zephyr5028/pese-ruche-lora-esp32/schemas/systeme pesee ruche 3.pdf

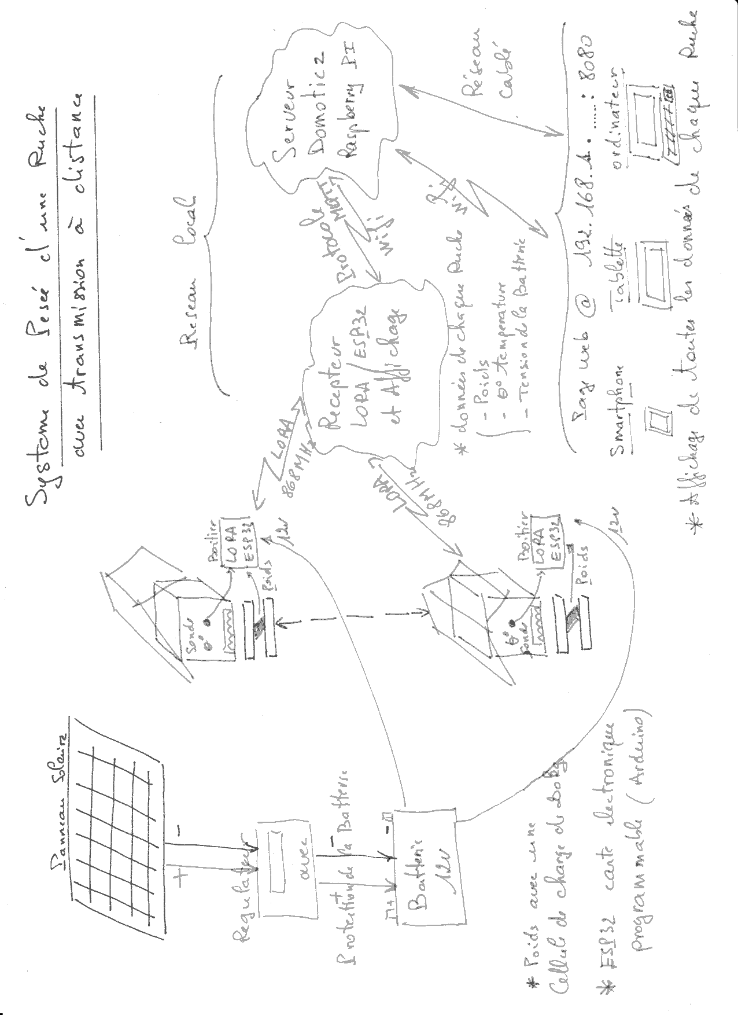
[picture p2: page 1]
