zephyr5028/pese-ruche-lora-esp32/documentation/pese ruche support.pdf

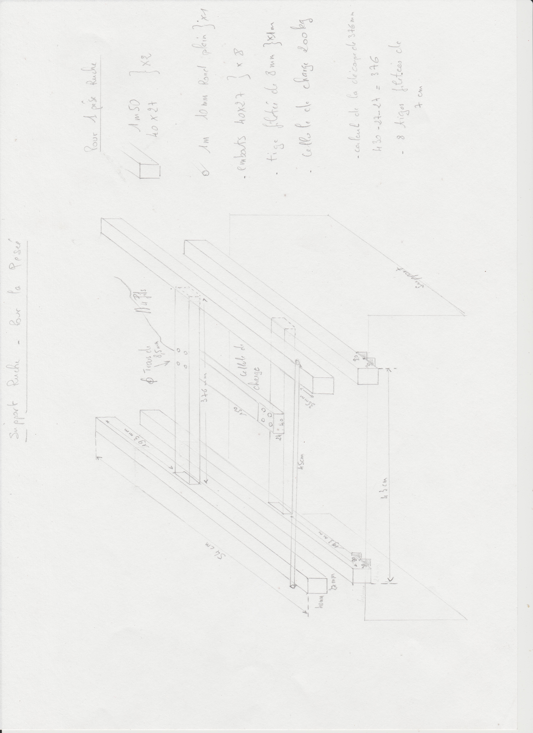
[picture p3: page 1]
