zephyr5028/pese-ruche-lora-esp32/schemas/schema pese ruche rfm95 esp32.pdf

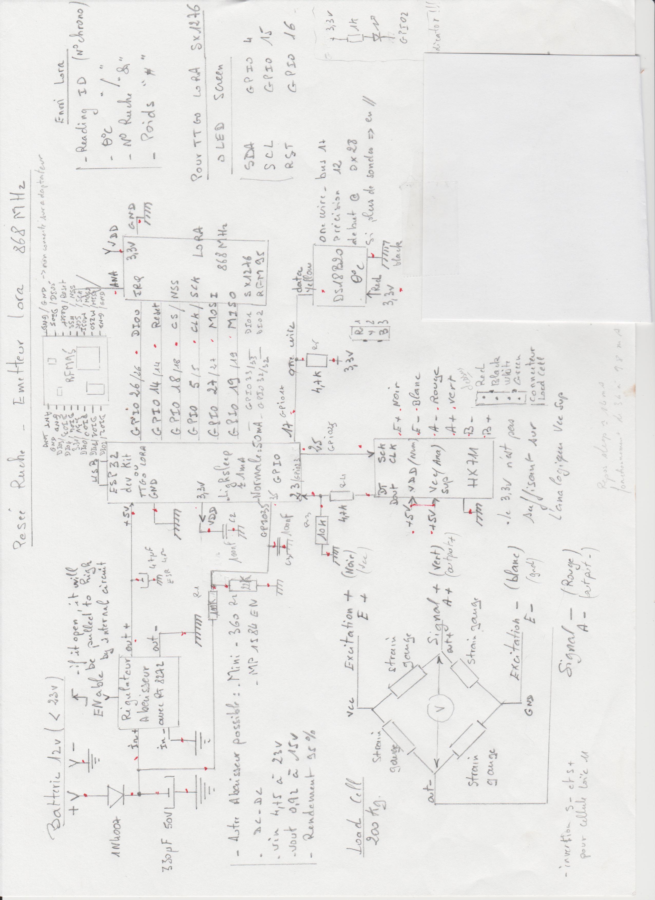
[picture p4: page 1]
