zephyr5028/pese-ruche-lora-esp32/schemas/plan pese ruche acier 200kg.pdf

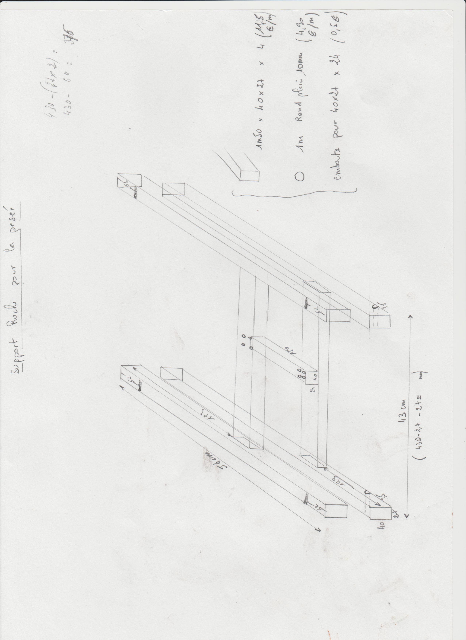
[picture p5: page 1]
