zephyr5028/pese-ruche-lora-esp32/images/boitier_emetteur_pese_ruche.jpg

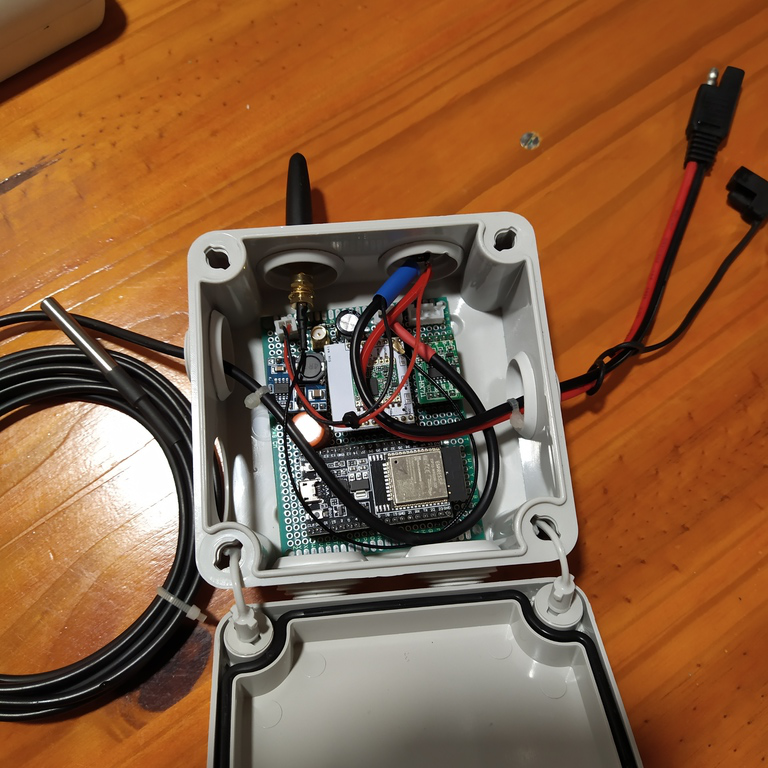
images/boitier_emetteur_pese_ruche.jpg
