zephyr5028/pese-ruche-lora-esp32/images/carte_emetteur.jpg

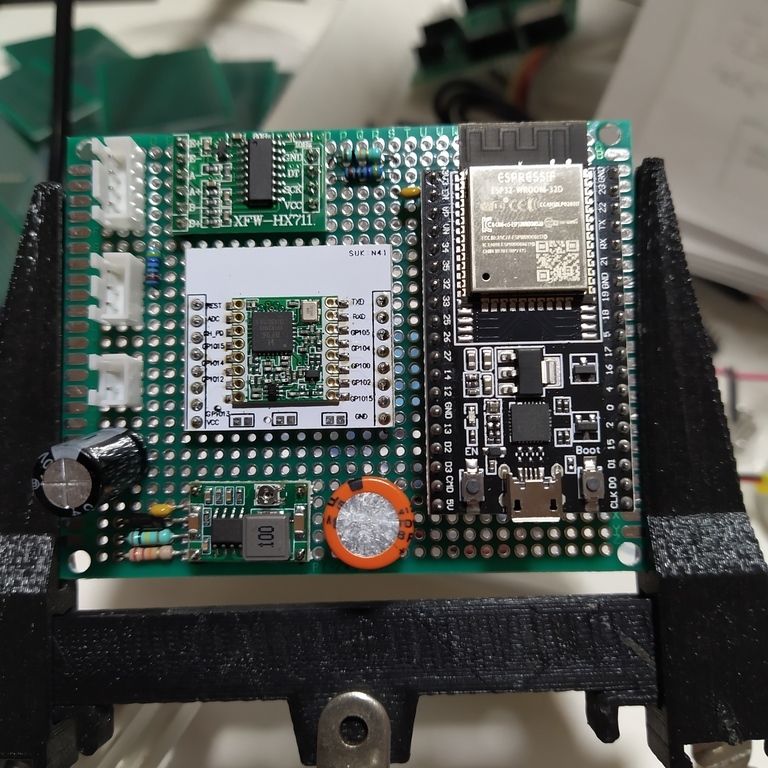
images/carte_emetteur.jpg
