zephyr5028/pese-ruche-lora-esp32/images/carte_equipee_emetteur_pese_ruche.jpg

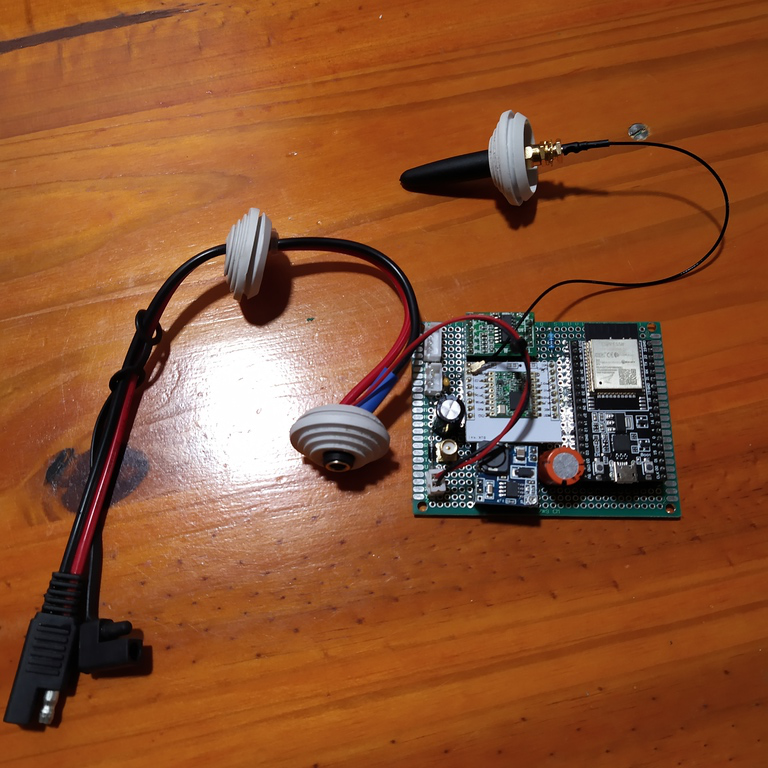
images/carte_equipee_emetteur_pese_ruche.jpg
