zephyr5028/pese-ruche-lora-esp32/ruche_LoRa_Receiver_Web_Server/data/winter.jpg

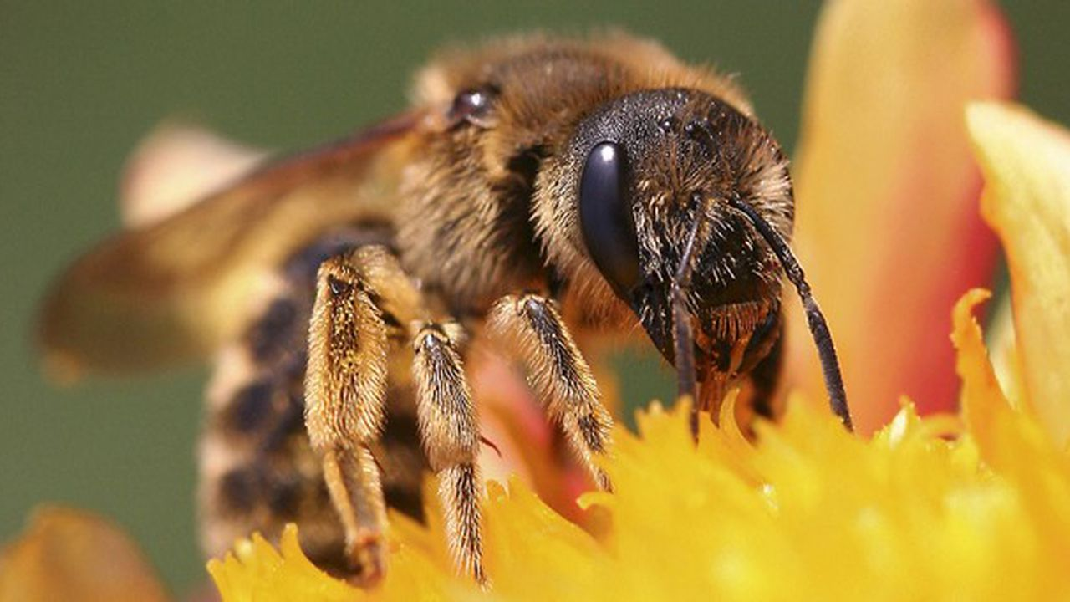
ruche_LoRa_Receiver_Web_Server/data/winter.jpg
