zephyr5028/pese-ruche-lora-esp32/3d/glissiere boitier ruche.stl

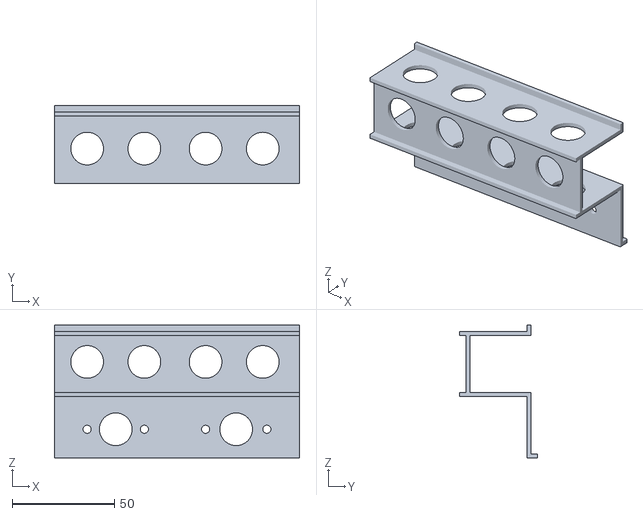
[picture p10: CAD file, 2022-12-07]
3d/glissiere boitier ruche.stl
120.0 x 38.0 x 65.0
