zephyr5028/pese-ruche-lora-esp32/schemas/Schematic_capteur-autonome-domoticz-contacteur-attiny85_2025-06-28.pdf

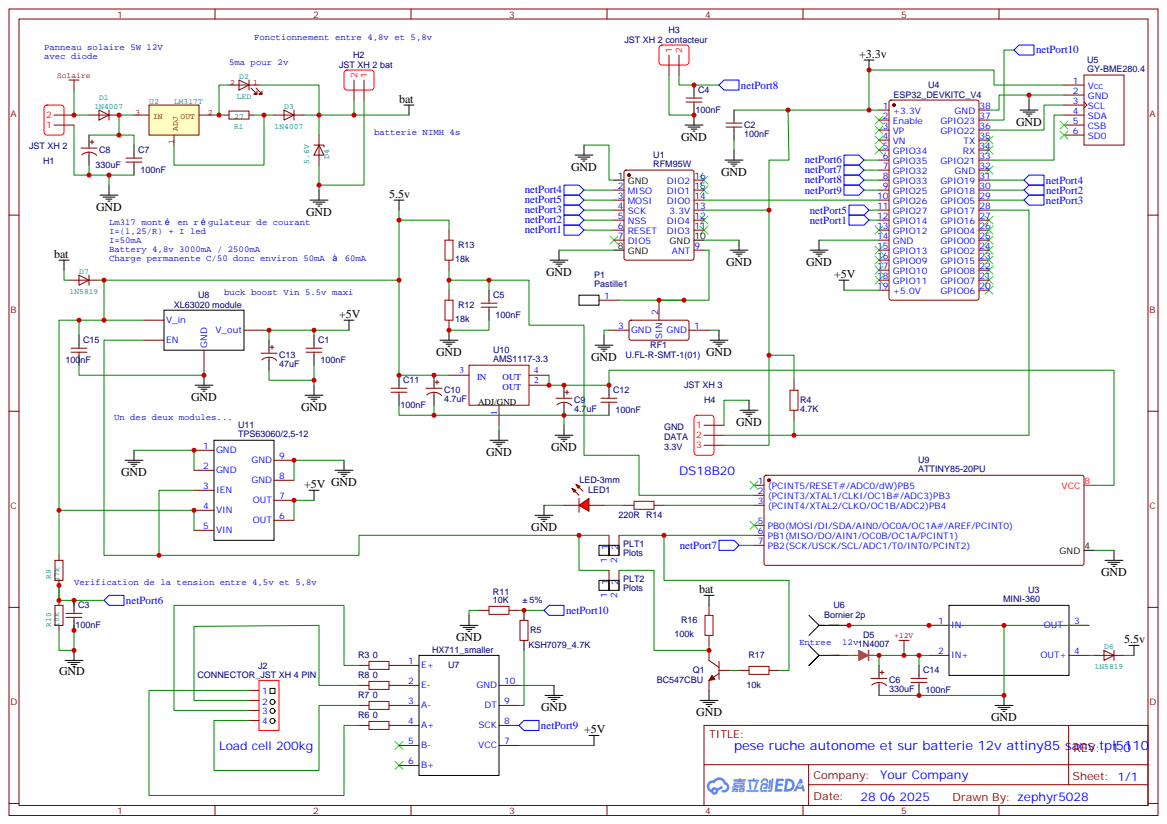
[picture p12: page 1]

Un des deux modules...

(PCINT5/RESET#/ADC0/dW)PB5 1
(PCINT3/XTAL1/CLKI/OC1B#/ADC3)PB3 2
(PCINT4/XTAL2/CLKO/OC1B/ADC2)PB4 3
PB0(MOSI/DI/SDA/AIN0/OC0A/OC1A#/AREF/PCINT0) 5
PB1(MISO/DO/AIN1/OC0B/OC1A/PCINT1) 6
PB2(SCK/USCK/SCL/ADC1/T0/INT0/PCINT2) 7

GND
TITLE:
pese ruche autonome et sur batterie 12v attiny85 sans tpl5110 REV: 1.0
