zephyr5028/pese-ruche-lora-esp32/schemas/Schematic_pese_ruche_lora-avec-tpl510_2024-12-31.pdf

## Batterie 12v

## abaisseur dc-dc 12v vers 5,20v

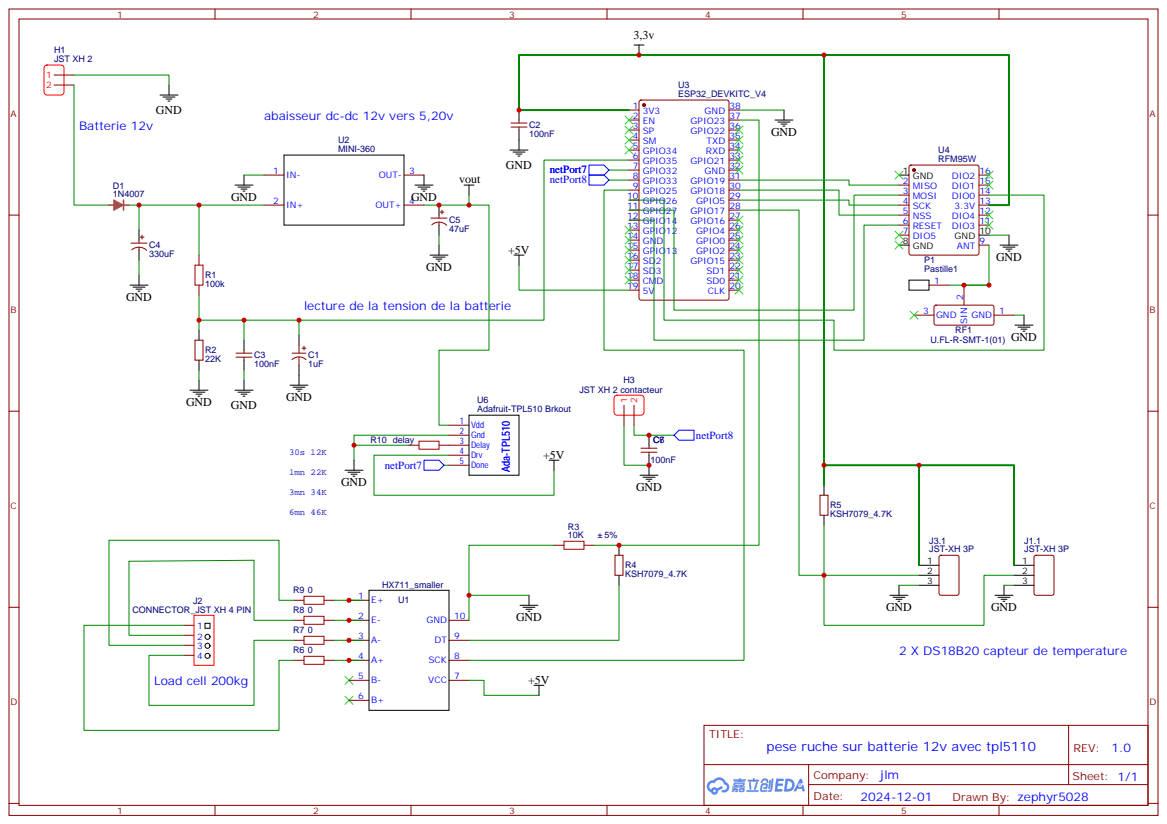
[picture p13: page 1]

lecture de la tension de la batterie
