zephyr5028/pese-ruche-lora-esp32/schemas/Schematic_pese_ruche_lora_2023-01-26.pdf

## Batterie 12v

## Antenne SMA

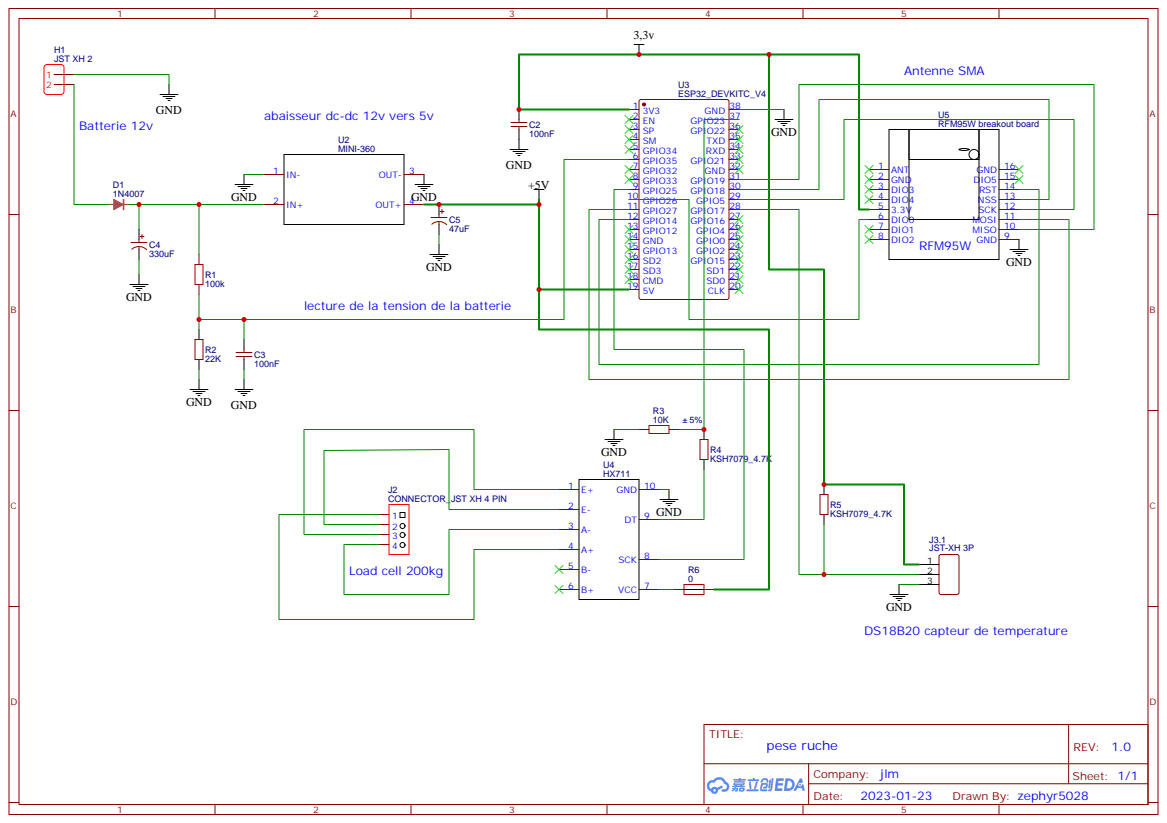
[picture p14: page 1]

abaisseur dc-dc 12v vers 5v

lecture de la tension de la batterie
