zephyr5028/pese-ruche-lora-esp32/schemas/PCB_PCB_capteur_autonome_et_sur_batterie-12v_attiny85_2025-06-28.pdf

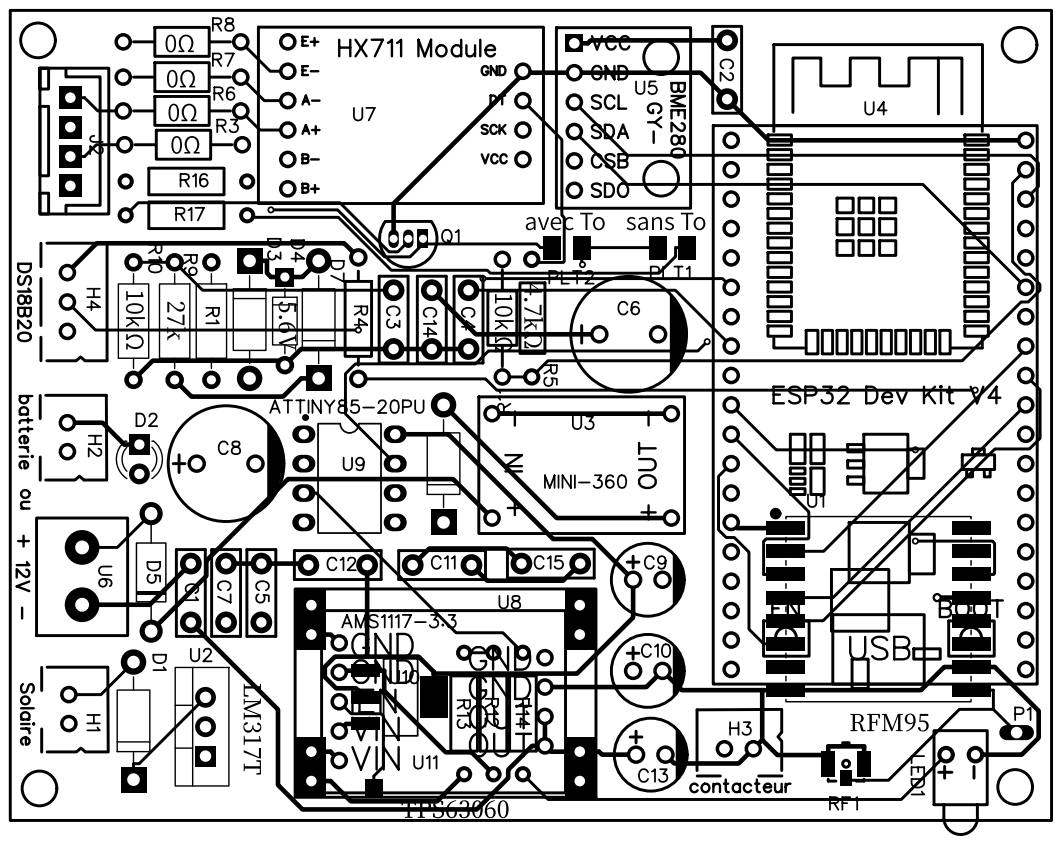
[picture p15: page 1]
