zephyr5028/pese-ruche-lora-esp32/(commit log)

2022-12-07 initialisation du pese ruche suivi par git
    [glissiere 45 boitier ruche.stl, glissiere boitier ruche.stl]
2023-01-20 basculement vers arduinojson v6
2023-03-08 augmentation nombre de ruches 12 a 14
2023-03-10 ruche 03 correction alimentation
    [variables.h]
2023-03-10 ruche 16 correction alimentation
    [variables.h]
2023-03-11 correction tension batterie
2023-05-26 ruche 03 avec invesion E+ et E-, modification de l routine tensionBatterie
2023-05-28 ruche 03 correction tension batterie
    [variables.h]
2023-06-06 tension batterie sur la ruche 04 et surtout la nouvelle carte
2023-06-19 delay d'affichage programme calibration
2023-07-02 correction pour ruche 4
    [ruche_LoRa_Receiver_Web_Server.ino]
2023-07-04 pb calibration hx711 resolu par power down puis power up du hx 711 au setup
2023-07-04 ruche n4 terminee et en place. preparation pour la ruche 5 autonome
2023-07-12 ruche5 sur domoticz pour essais avec les autres capteurs - tjs pb stabilite pesee en cours
2023-07-14 ruche 5 - masse de la cellule de charge reliee pour eviter le bruit
2023-07-17 mesures plus constantes sur la ruche en essai n5
2023-08-11 ajout recepteur reset tous les 24h
    [ruche_LoRa_Receiver_Web_Server.ino, variables.h]
2023-08-22 recepteur lora ruches domoticz reset tous les 24h et correction multiwifi
    [ruche_LoRa_Receiver_Web_Server.ino, variables.h]
2024-06-01 emetteur lora mise simplification lecture de sondes
2024-11-29 parametres pour la ruche n07
2024-12-15 ajout de deux sondes ds18b20
2024-12-15 correction variation poids ruche 07
    [esp32_hx711_ds18b20_lora_emetteur.ino]
2025-05-05 routine difference de poids rapide indique un essaimage
2025-06-23 ruche n6 avec cellule de charge
2025-06-28 pcb pese ruche autonome et sur batterie 12v attiny85 sans tpl5110
2025-07-03 compensation en temperature pour la ruche 6
